Ziad-Ashraf-Abdu/smart-lumbar-trainer/validated_results/session_results.xlsx

Key images
Name | Time (s)
14.48 | 14.482
29.26 | 29.264
31.90 | 31.900
34.77 | 34.770
37.34 | 37.339
42.24 | 42.244
45.75 | 45.748
Distances
Name | Time (s) | Length (px)
Line 8 | 14.482 | 85.41
Line 9 | 14.482 | 74.80
Line 6 | 29.264 | 71.97
Line 7 | 29.264 | 81.03
Line 1 | 31.900 | 0.00
Line 2 | 31.900 | 96.25
Line 3 | 31.900 | 0.00
Line 4 | 31.900 | 0.00
Line 5 | 31.900 | 53.27
Line 10 | 34.770 | 80.06
Line 11 | 34.770 | 106.32
Line 12 | 37.339 | 70.22
Line 13 | 37.339 | 87.44
Line 14 | 42.244 | 108.79
Line 15 | 42.244 | 64.55
Line 16 | 45.748 | 66.47
Line 17 | 45.748 | 61.37
Angles
Name | Time (s) | Value (°)
Angle 1 | 14.482 | 21.11
Angle 2 | 29.264 | 0.97
Angle 3 | 31.900 | 27.72
Angle 4 | 34.770 | 11.05
Angle 5 | 37.339 | 29.42
Angle 6 | 42.244 | -26.06
Angle 7 | 45.748 | 33.13
