Ziad-Ashraf-Abdu/smart-lumbar-trainer/validated_results/end_movement_1.jpg

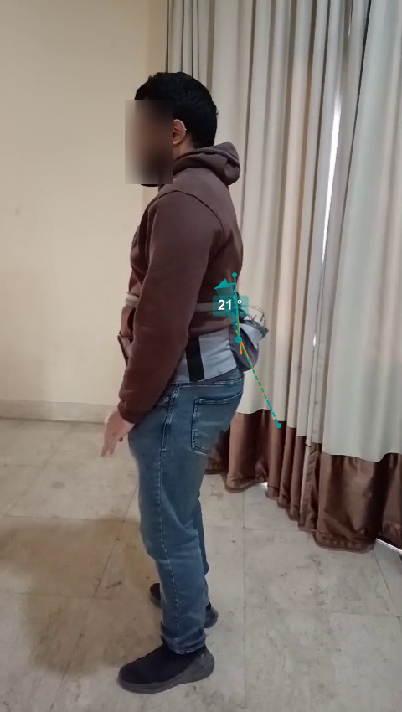
validated_results/end_movement_1.jpg
