Ziad-Ashraf-Abdu/smart-lumbar-trainer/validated_results/end_movement_2.jpg

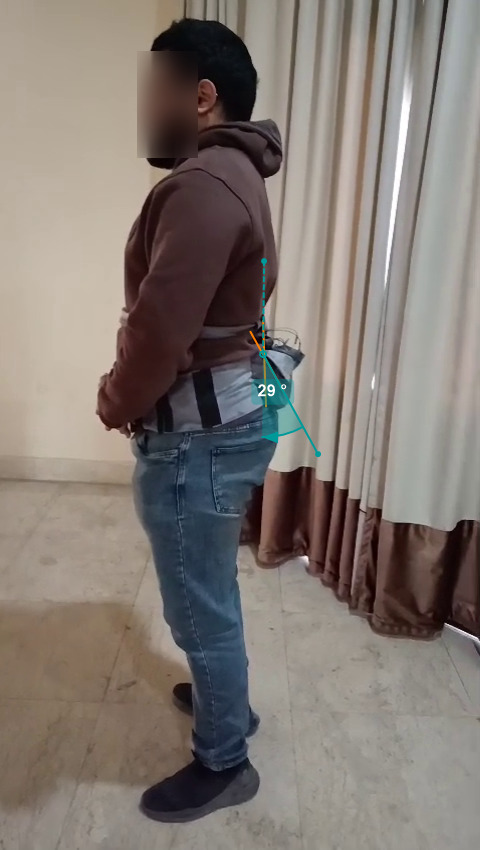
validated_results/end_movement_2.jpg
