Ziad-Ashraf-Abdu/smart-lumbar-trainer/validated_results/end_movement_3.jpg

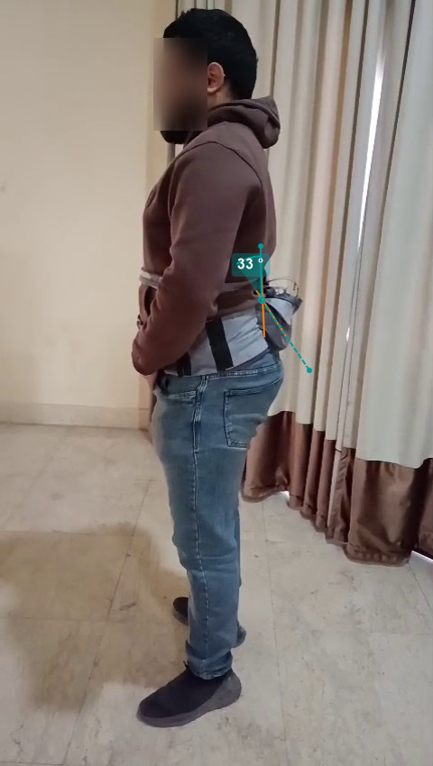
validated_results/end_movement_3.jpg
