Ziad-Ashraf-Abdu/smart-lumbar-trainer/validated_results/natural_position.jpg

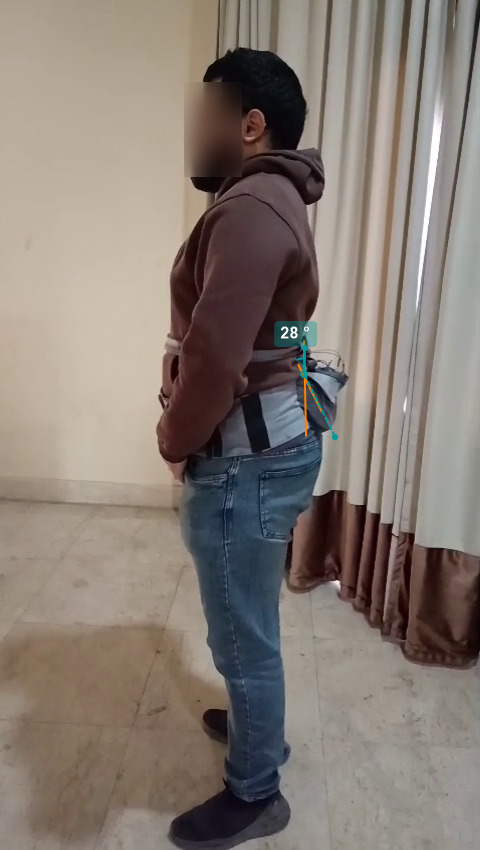
validated_results/natural_position.jpg
