Ziad-Ashraf-Abdu/smart-lumbar-trainer/validated_results/start_movement_1.jpg

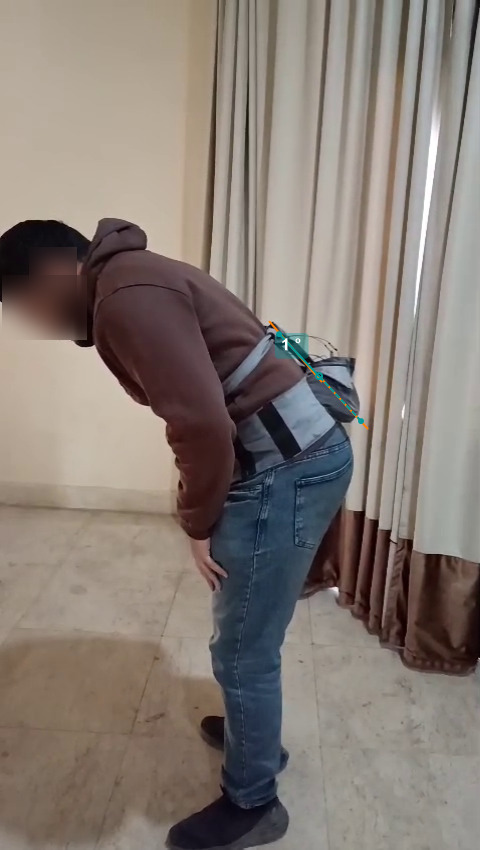
validated_results/start_movement_1.jpg
