Ziad-Ashraf-Abdu/smart-lumbar-trainer/(commit log)

2025-12-27 IMU firmware
2025-12-27 Create README
    Add detailed project documentation for the Dual-IMU Smart Trainer, including features, usage instructions, technical implementation, and acknowledgements.
2025-12-28 Validated Results
    [session_results.xlsx]
2025-12-29 Revise headings for motor learning and risk profiling
    Updated section headings for clarity and specificity, enhancing the description of motor learning and longitudinal risk profiling.
2025-12-29 Remove secure wireless communication section from README
    Removed section on secure wireless communication details.
2025-12-29 Add conclusion section to README.md
    The conclusion section summarizes the Dual-IMU Smart Trainer's capabilities in lumbar posture monitoring, detailing its features, experimental validation, and implications for injury prevention.
2025-12-29 Update README with OLED power consumption details
    Added note on OLED power consumption and future improvements.
